devjamescollier/ESP-32_Based_Avionics_and_Telemetry_Board/Manufacturing/Assembly/BOM.csv

Comment | Designator | Footprint | LCSC Part #
100n | C1,C2,C3,C4,C5,C6,C8,C11,C13,C19,C21,C23,C25,C28 | C_0603_1608Metric | C14663
1u | C7,C15 | C_0603_1608Metric | C15849
10u | C12,C16,C20,C22,C27 | C_0805_2012Metric | C15850
4.7u | C14 | C_0805_2012Metric | C1779
22u | C17,C24 | C_0805_2012Metric | C45783
100u | C18,C26 | CP_Elec_6.3x5.4 | C7469933
YelGrn | D1 | LED_0603_1608Metric | C965805
Yellow | D2 | LED_0603_1608Metric | C89811
Red | D3 | LED_0603_1608Metric | C2286
SS54 | D4,D5 | D_SMA | C22452
B5819WS | D6 | D_SOD-323 | C64886
15A | F1 | Fuse_Littelfuse-NANO2-451_453 | C44480
Micro_SD_Card | J1 | microSD_HC_Hirose_DM3AT-SF-PEJM5 | C114218
USB_B_Micro | J6 | USB_Micro-B_Molex-105017-0001_EdgeSilk | C136000
4.7u | L1 | L_Changjiang_FNR4030S | C167874
MMBT3904 | Q1,Q2,Q3 | SOT-23 | C20526
AO4407A | Q4,Q5 | SOIC-8_3.9x4.9mm_P1.27mm | C16072
10k | R1,R2,R4,R5,R14,R15,R16,R17,R21,R22,R23,R27,R38,R39 | R_0603_1608Metric | C25804
100k | R3,R24,R28,R34,R35,R36,R37 | R_0603_1608Metric | C25803
4.7k | R8,R9 | R_0603_1608Metric | C23162
1k | R11,R12,R13,R18,R26,R29,R30,R31,R32,R33 | R_0603_1608Metric | C21190
22.1k | R19 | R_0603_1608Metric | C137768
47.5k | R20 | R_0603_1608Metric | C23061
39k | R25 | R_0603_1608Metric | C23153
SW_Push | SW1,SW2 | SW_Push_1P1T_XKB_TS-1187A | C318884
ESP32-WROOM-32E-N4 | U1 | ESP32-WROOM-32E_Espressif | C701341
ASM330LHHTR | U2 | LGA-14_3x2.5mm_P0.5mm_LayoutBorder3x4y | C459826
LSM6DSV32XTR | U3 | LGA-14_3x2.5mm_P0.5mm_LayoutBorder3x4y | C22461202
MS5611-01BA03 | U4 | TE_MS5611-01BA03_LGA-8_3x5mm_P1.25mm | C15639
LIS3MDLTR | U5 | LGA-12_2x2mm_P0.5mm | C478483
CP2102N-A02-GQFN28 | U6 | QFN-28-1EP_5x5mm_P0.5mm_EP3.35x3.35mm | C964632
AP63203WU-7 | U9 | TSOT-23-6 | C780769
USBLC6-2SC6 | U10 | SOT-23-6 | C7519
