devjamescollier/ESP-32_Based_Avionics_and_Telemetry_Board/Hardware/KiCad_Files/3D_Models/XT30PW-M.step

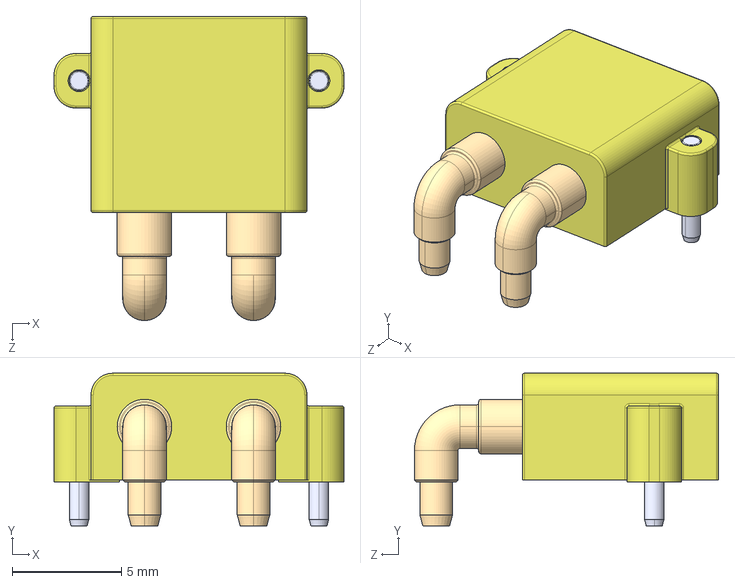
[picture p4: CAD file, 2025-08-06]
Hardware/KiCad_Files/3D_Models/XT30PW-M.step
13.3 x 7.00 x 14.0 mm
