devjamescollier/ESP-32_Based_Avionics_and_Telemetry_Board/Hardware/KiCad_Files/3D_Models/D_SOD-323.step

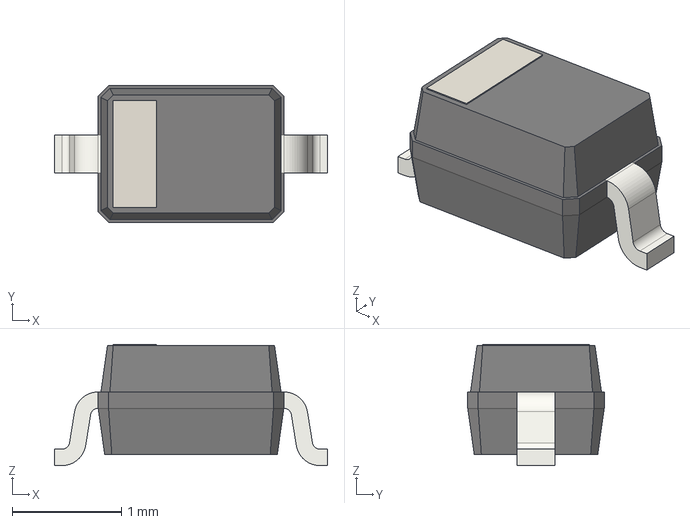
[picture p5: CAD file, 2025-08-06]
Hardware/KiCad_Files/3D_Models/D_SOD-323.step
2.50 x 1.25 x 1.11 mm
