devjamescollier/ESP-32_Based_Avionics_and_Telemetry_Board/Hardware/KiCad_Files/3D_Models/C_0805_2012Metric.step

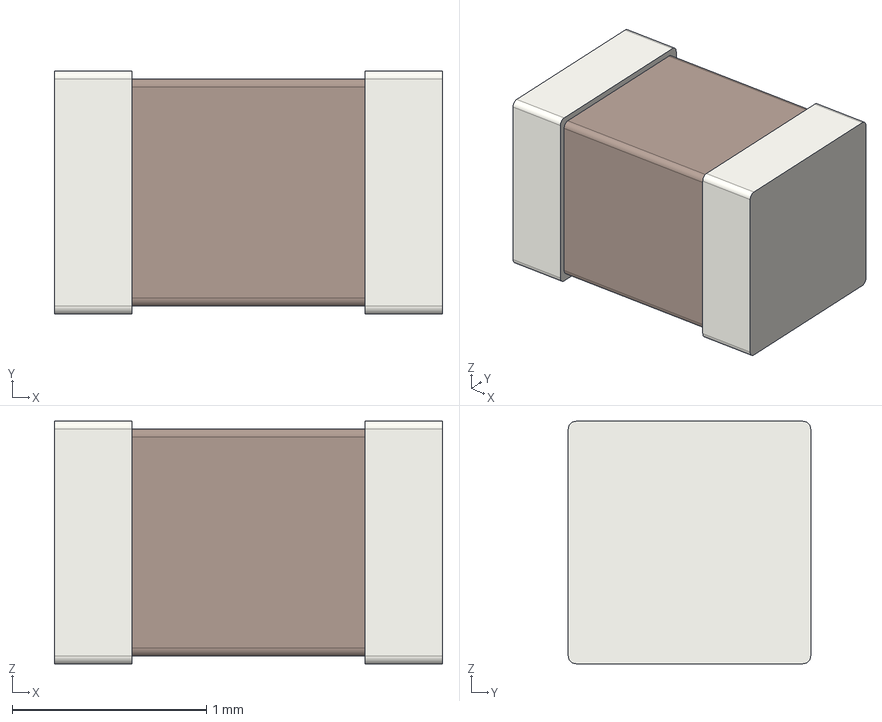
[picture p6: CAD file, 2025-08-06]
Hardware/KiCad_Files/3D_Models/C_0805_2012Metric.step
2.00 x 1.25 x 1.25 mm
