devjamescollier/ESP-32_Based_Avionics_and_Telemetry_Board/Hardware/KiCad_Files/3D_Models/SOT-23-6.step

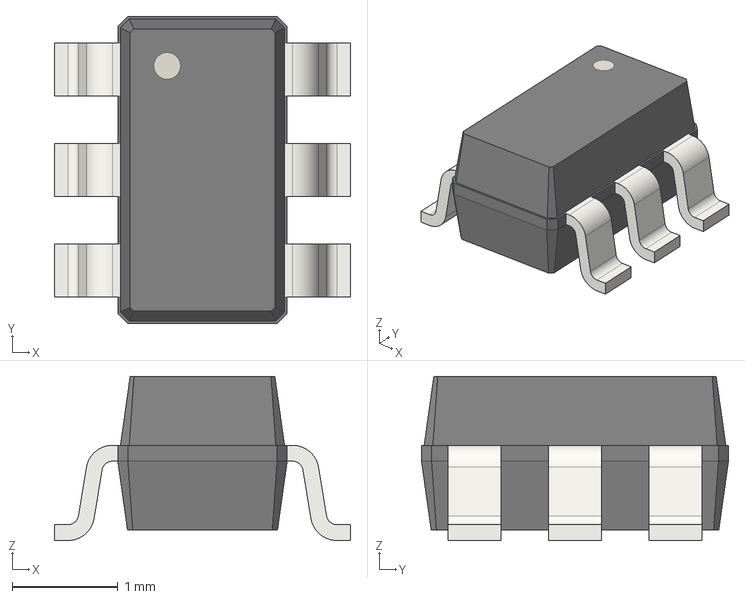
[picture p7: CAD file, 2025-08-06]
Hardware/KiCad_Files/3D_Models/SOT-23-6.step
2.80 x 2.90 x 1.55 mm
