devjamescollier/ESP-32_Based_Avionics_and_Telemetry_Board/Hardware/KiCad_Files/3D_Models/CP_Elec_6.3x5.4.step

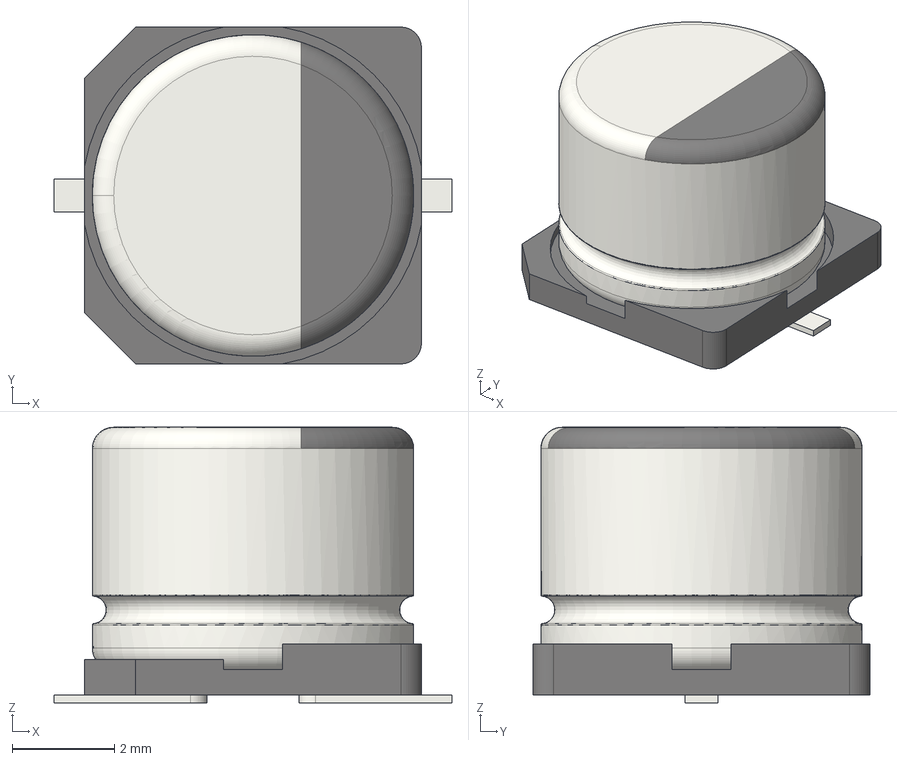
[picture p8: CAD file, 2025-08-06]
Hardware/KiCad_Files/3D_Models/CP_Elec_6.3x5.4.step
7.80 x 6.60 x 5.40 mm
