devjamescollier/ESP-32_Based_Avionics_and_Telemetry_Board/Hardware/KiCad_Files/3D_Models/L_Changjiang_FNR4030S.step

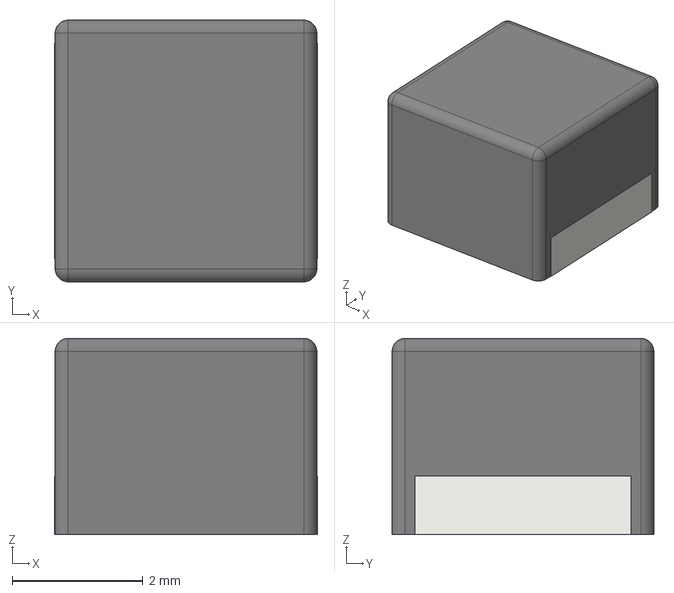
[picture p9: CAD file, 2025-08-06]
Hardware/KiCad_Files/3D_Models/L_Changjiang_FNR4030S.step
4.02 x 4.00 x 3.00 mm
