devjamescollier/ESP-32_Based_Avionics_and_Telemetry_Board/Hardware/KiCad_Files/3D_Models/C_0603_1608Metric.step

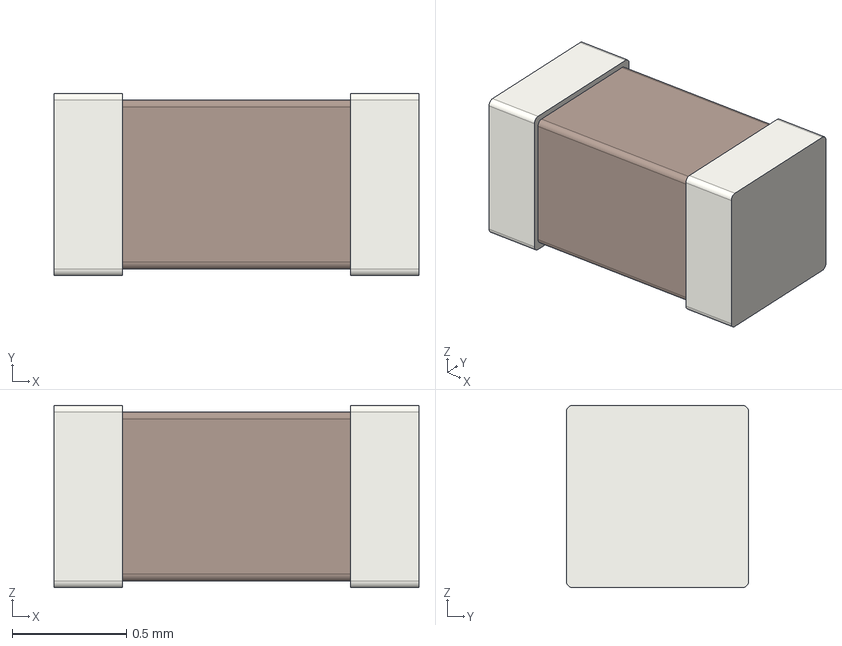
[picture p10: CAD file, 2025-08-06]
Hardware/KiCad_Files/3D_Models/C_0603_1608Metric.step
1.60 x 0.8 x 0.8 mm
