devjamescollier/ESP-32_Based_Avionics_and_Telemetry_Board/Hardware/KiCad_Files/3D_Models/PinHeader_1x03_P2.54mm_Vertical.step

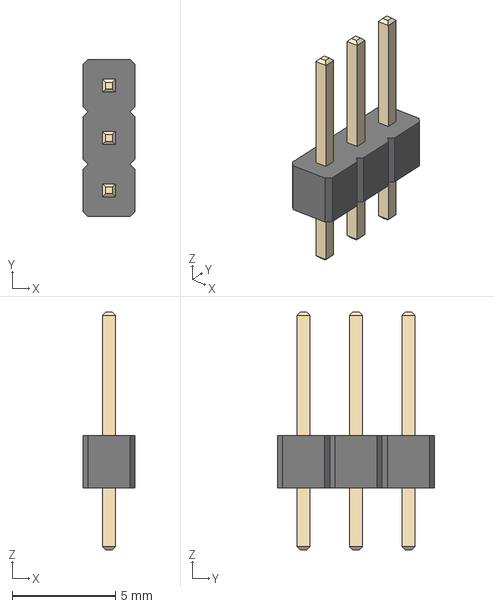
[picture p13: CAD file, 2025-08-06]
Hardware/KiCad_Files/3D_Models/PinHeader_1x03_P2.54mm_Vertical.step
2.54 x 7.62 x 11.5 mm
