devjamescollier/ESP-32_Based_Avionics_and_Telemetry_Board/Hardware/KiCad_Files/3D_Models/SS12D10G5.step

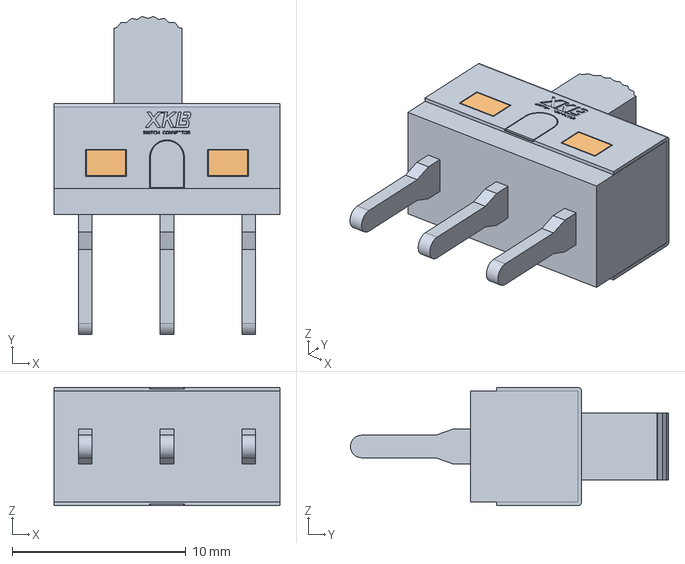
[picture p14: CAD file, 2025-08-06]
Hardware/KiCad_Files/3D_Models/SS12D10G5.step
13.0 x 18.3 x 6.80 mm
