devjamescollier/ESP-32_Based_Avionics_and_Telemetry_Board/Hardware/KiCad_Files/3D_Models/D_SMA.step

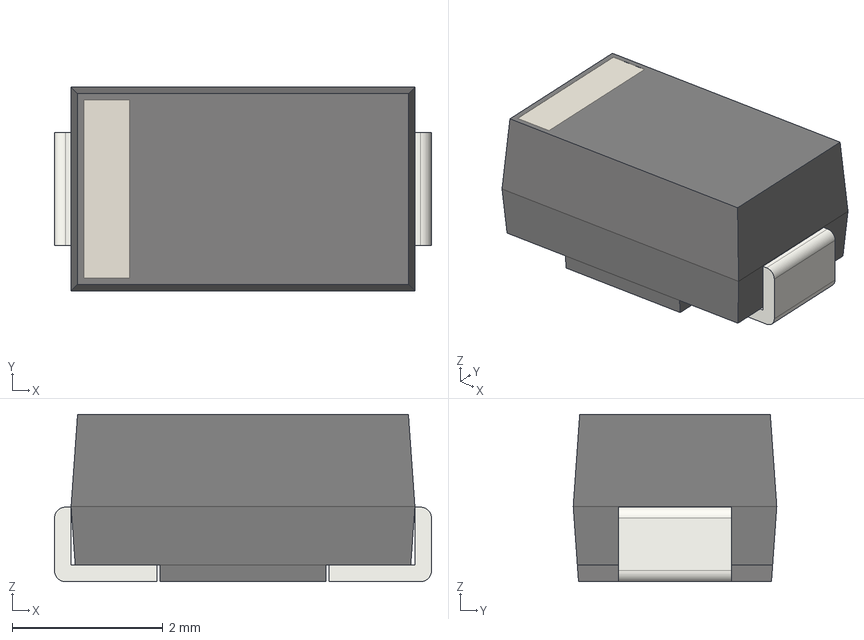
[picture p15: CAD file, 2025-08-06]
Hardware/KiCad_Files/3D_Models/D_SMA.step
5.00 x 2.70 x 2.22 mm
