devjamescollier/ESP-32_Based_Avionics_and_Telemetry_Board/Hardware/KiCad_Files/3D_Models/Littelfuse_0451.step

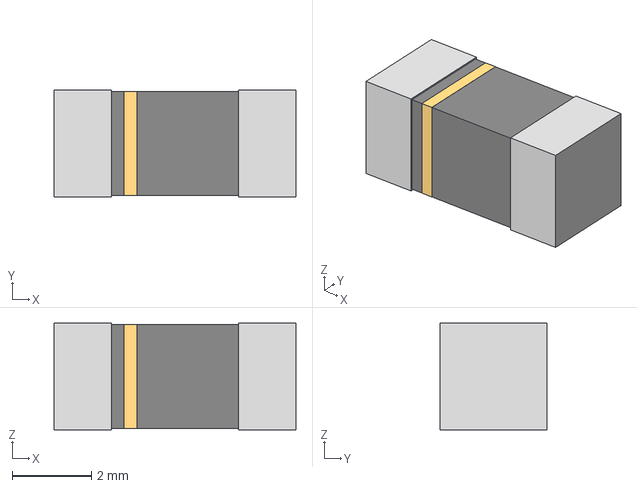
[picture p16: CAD file, 2025-08-06]
Hardware/KiCad_Files/3D_Models/Littelfuse_0451.step
6.10 x 2.69 x 2.69 mm
