devjamescollier/ESP-32_Based_Avionics_and_Telemetry_Board/Hardware/KiCad_Files/3D_Models/Buzzer_12x9.5RM7.6.step

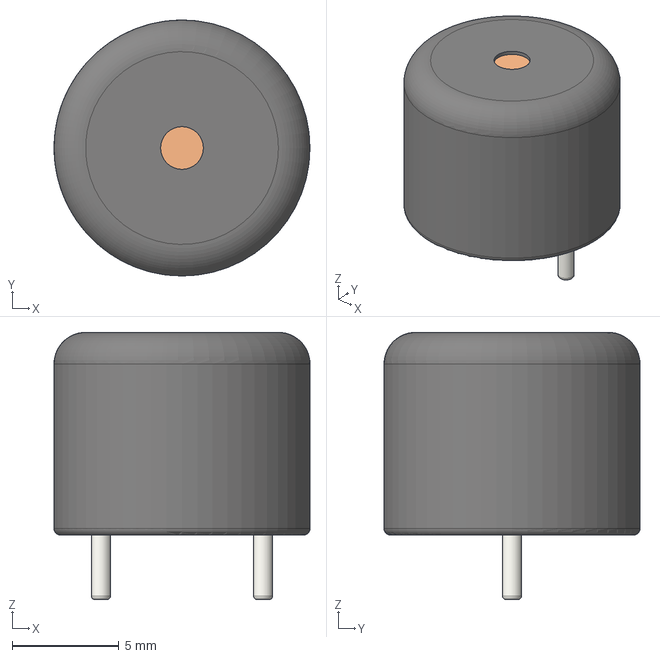
[picture p18: CAD file, 2025-08-06]
Hardware/KiCad_Files/3D_Models/Buzzer_12x9.5RM7.6.step
12.0 x 12.0 x 12.5 mm
