devjamescollier/ESP-32_Based_Avionics_and_Telemetry_Board/Hardware/KiCad_Files/3D_Models/SOT-23.step

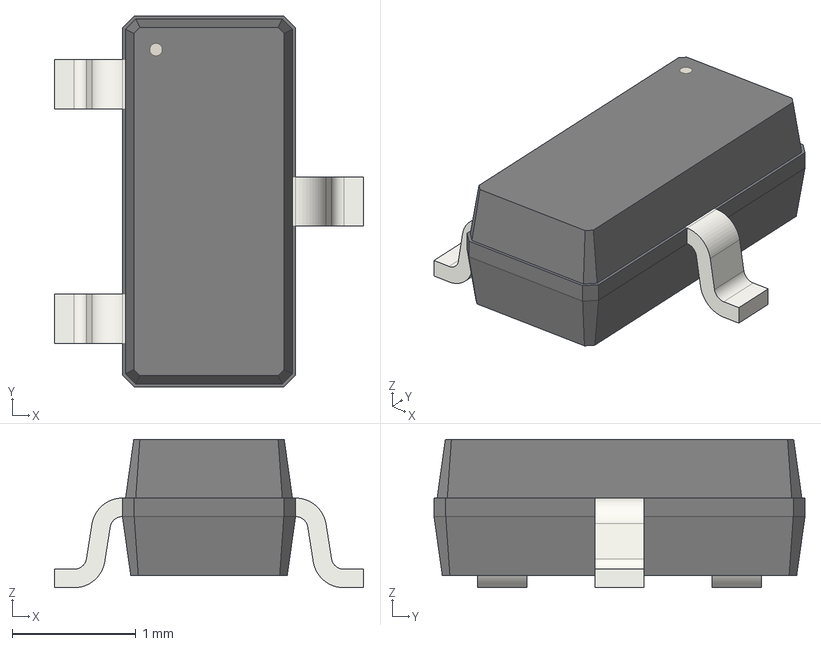
[picture p19: CAD file, 2025-08-06]
Hardware/KiCad_Files/3D_Models/SOT-23.step
2.50 x 3.00 x 1.20 mm
