devjamescollier/ESP-32_Based_Avionics_and_Telemetry_Board/Hardware/KiCad_Files/3D_Models/Molex_105017-0001.step

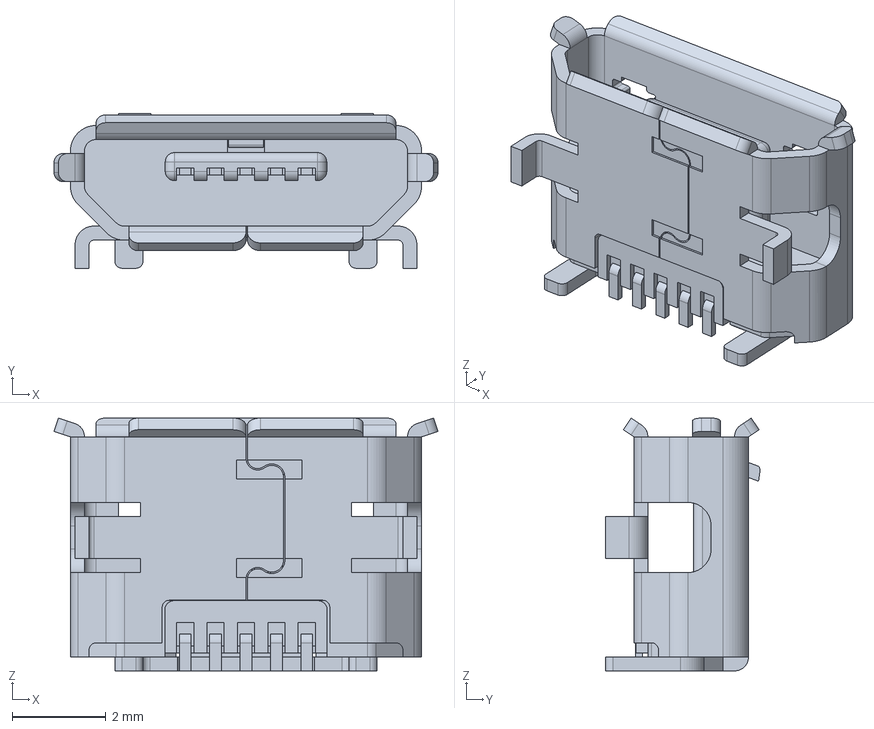
[picture p20: CAD file, 2025-08-06]
Hardware/KiCad_Files/3D_Models/Molex_105017-0001.step
8.20 x 3.30 x 5.40 mm
