devjamescollier/ESP-32_Based_Avionics_and_Telemetry_Board/Hardware/KiCad_Files/3D_Models/TS-1187A-B-A-B.step

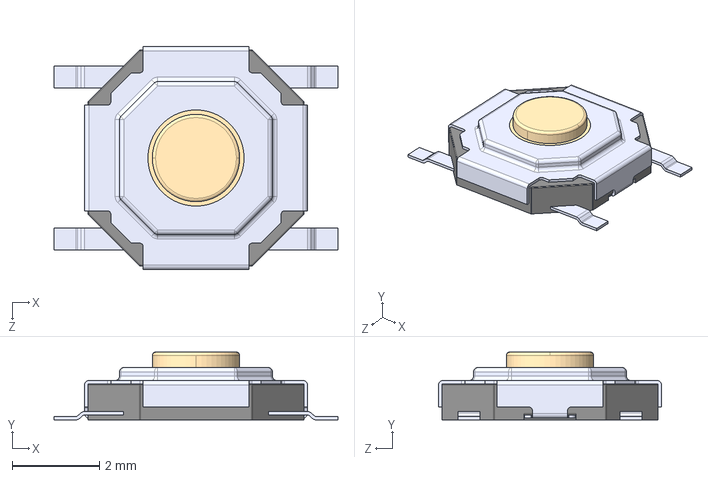
[picture p21: CAD file, 2025-08-06]
Hardware/KiCad_Files/3D_Models/TS-1187A-B-A-B.step
6.50 x 1.55 x 5.10 mm
