devjamescollier/ESP-32_Based_Avionics_and_Telemetry_Board/Hardware/KiCad_Files/3D_Models/LGA-12_2x2mm_P0.5mm.step

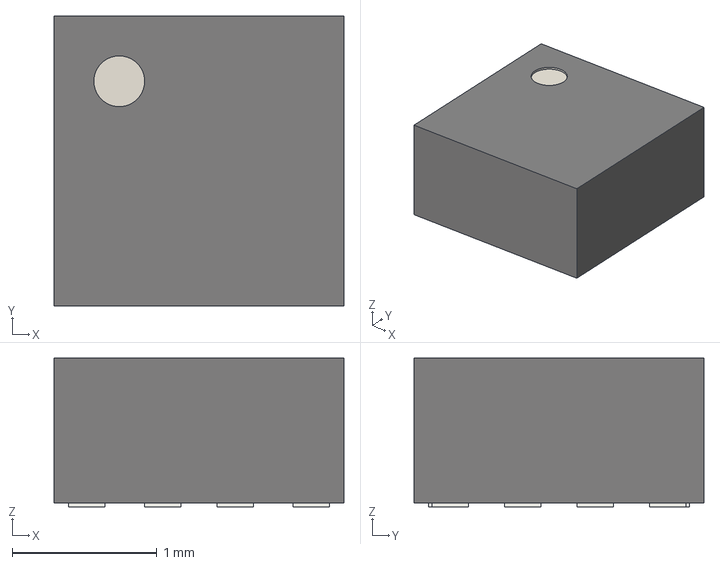
[picture p22: CAD file, 2025-08-05]
Hardware/KiCad_Files/3D_Models/LGA-12_2x2mm_P0.5mm.step
2.00 x 2.00 x 1.02 mm
