devjamescollier/ESP-32_Based_Avionics_and_Telemetry_Board/Hardware/KiCad_Files/3D_Models/LGA-14_3x2.5mm_P0.5mm_LayoutBorder3x4y.step

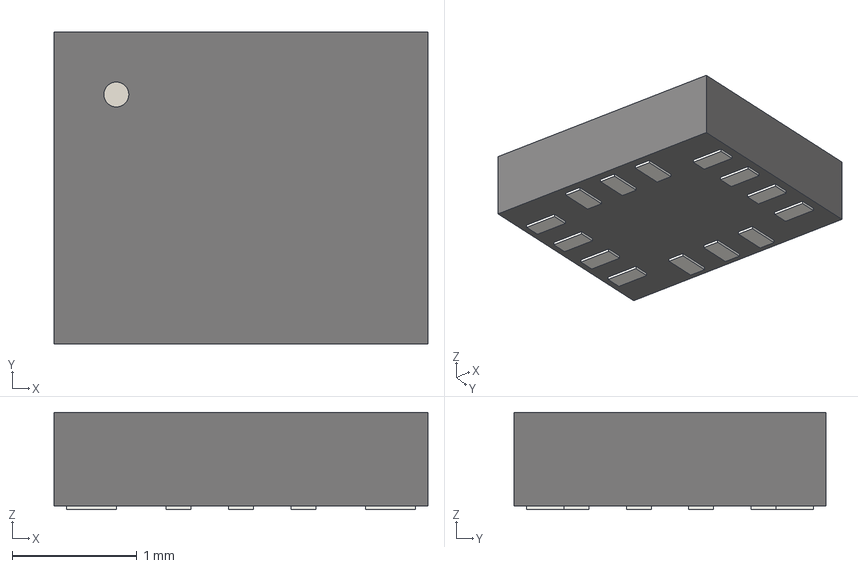
[picture p23: CAD file, 2025-08-05]
Hardware/KiCad_Files/3D_Models/LGA-14_3x2.5mm_P0.5mm_LayoutBorder3x4y.step
3.00 x 2.50 x 0.78 mm
