devjamescollier/ESP-32_Based_Avionics_and_Telemetry_Board/Hardware/KiCad_Files/3D_Models/microSD_HC_Hirose_DM3AT-SF-PEJM5.step

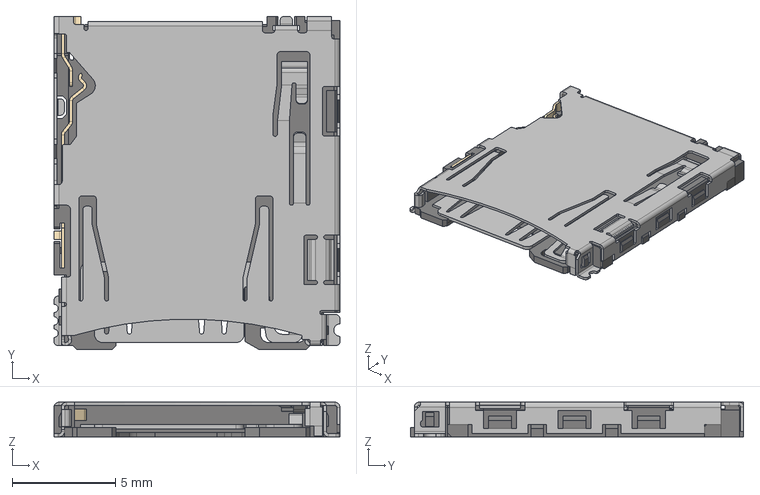
[picture p24: CAD file, 2025-08-05]
Hardware/KiCad_Files/3D_Models/microSD_HC_Hirose_DM3AT-SF-PEJM5.step
13.8 x 16.1 x 1.68 mm
