devjamescollier/ESP-32_Based_Avionics_and_Telemetry_Board/Hardware/KiCad_Files/3D_Models/SOIC-8_3.9x4.9mm_P1.27mm.step

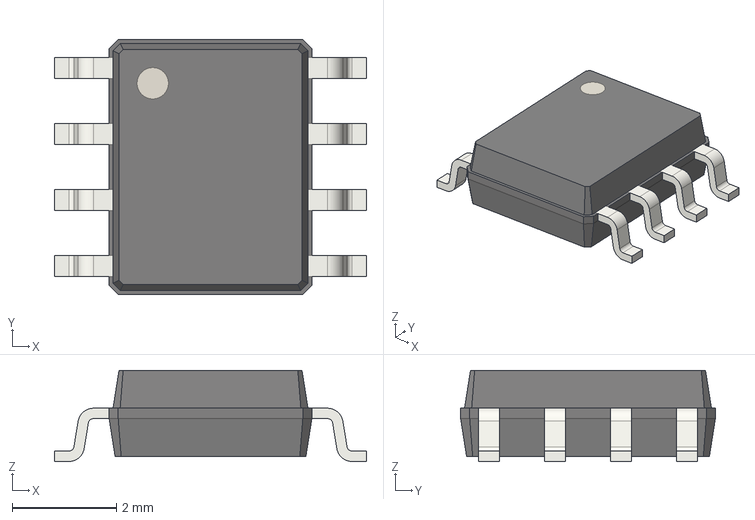
[picture p25: CAD file, 2025-08-05]
Hardware/KiCad_Files/3D_Models/SOIC-8_3.9x4.9mm_P1.27mm.step
6.00 x 4.90 x 1.75 mm
