devjamescollier/ESP-32_Based_Avionics_and_Telemetry_Board/Hardware/KiCad_Files/3D_Models/QFN-28-1EP_5x5mm_P0.5mm_EP3.35x3.35mm.step

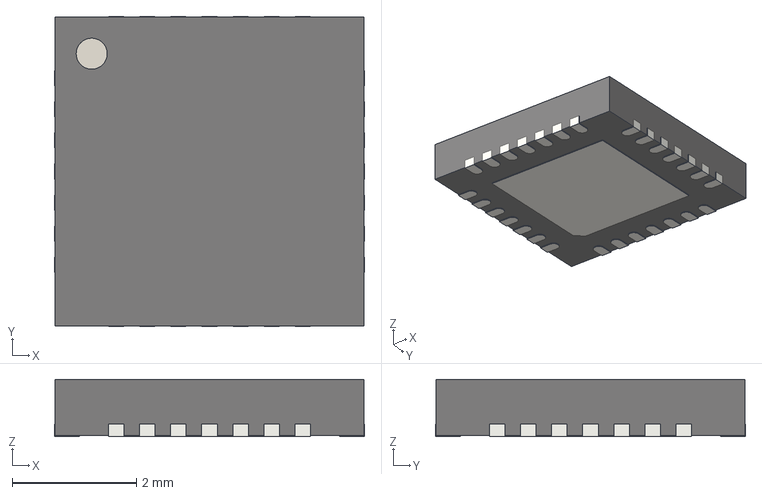
[picture p26: CAD file, 2025-08-05]
Hardware/KiCad_Files/3D_Models/QFN-28-1EP_5x5mm_P0.5mm_EP3.35x3.35mm.step
5.00 x 5.00 x 0.92 mm
