devjamescollier/ESP-32_Based_Avionics_and_Telemetry_Board/Hardware/KiCad_Files/3D_Models/ESP32-WROOM-32E.step

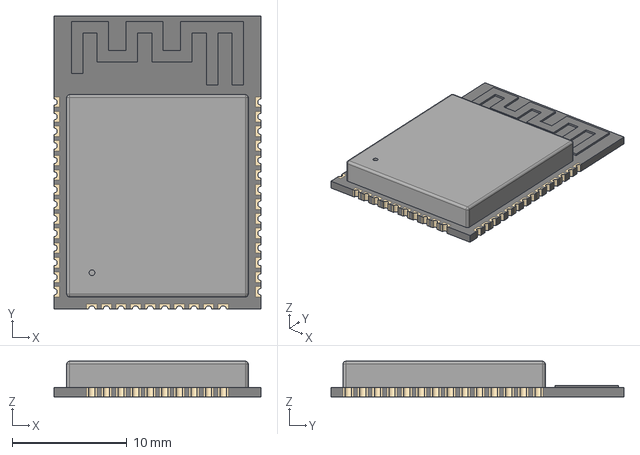
[picture p27: CAD file, 2025-08-05]
Hardware/KiCad_Files/3D_Models/ESP32-WROOM-32E.step
18.0 x 25.5 x 3.10 mm
