devjamescollier/ESP-32_Based_Avionics_and_Telemetry_Board/Hardware/KiCad_Files/ESP-32_Based_Avionics_Telemetry_Board.kicad_pcb

## KiCad design Hardware/KiCad_Files/ESP-32_Based_Avionics_Telemetry_Board.kicad_pcb (2025-08-11)

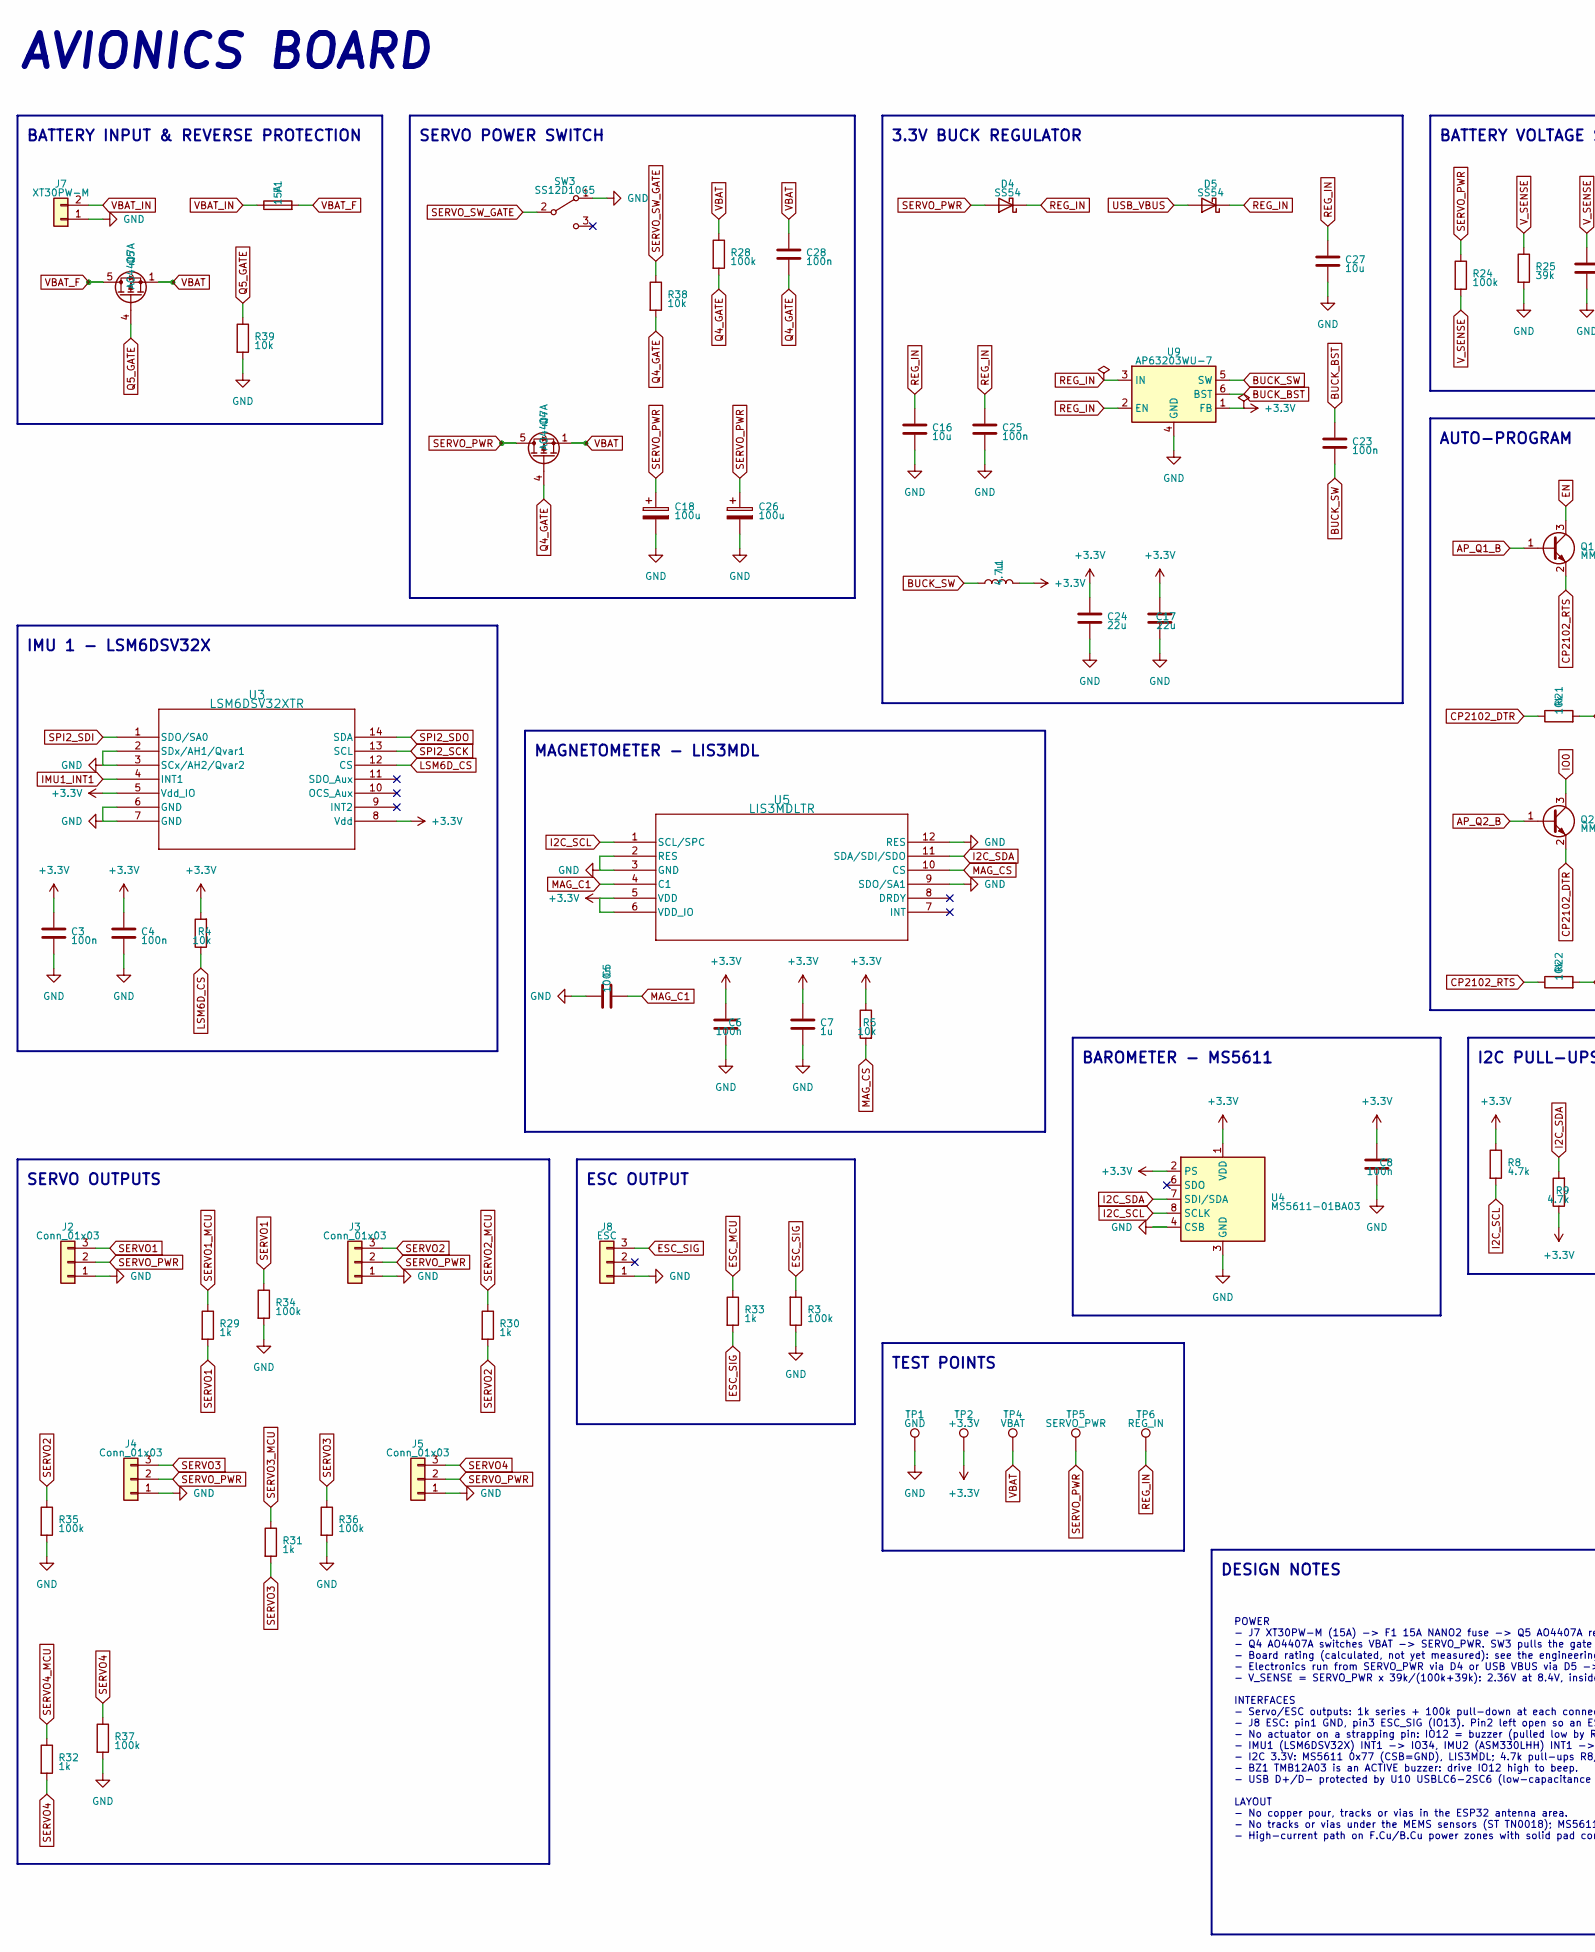
[picture p29: schematic ESP-32_Based_Avionics_Telemetry_Board.kicad_sch, ESP32-Based Avionics Board, part in row 1, column 1]

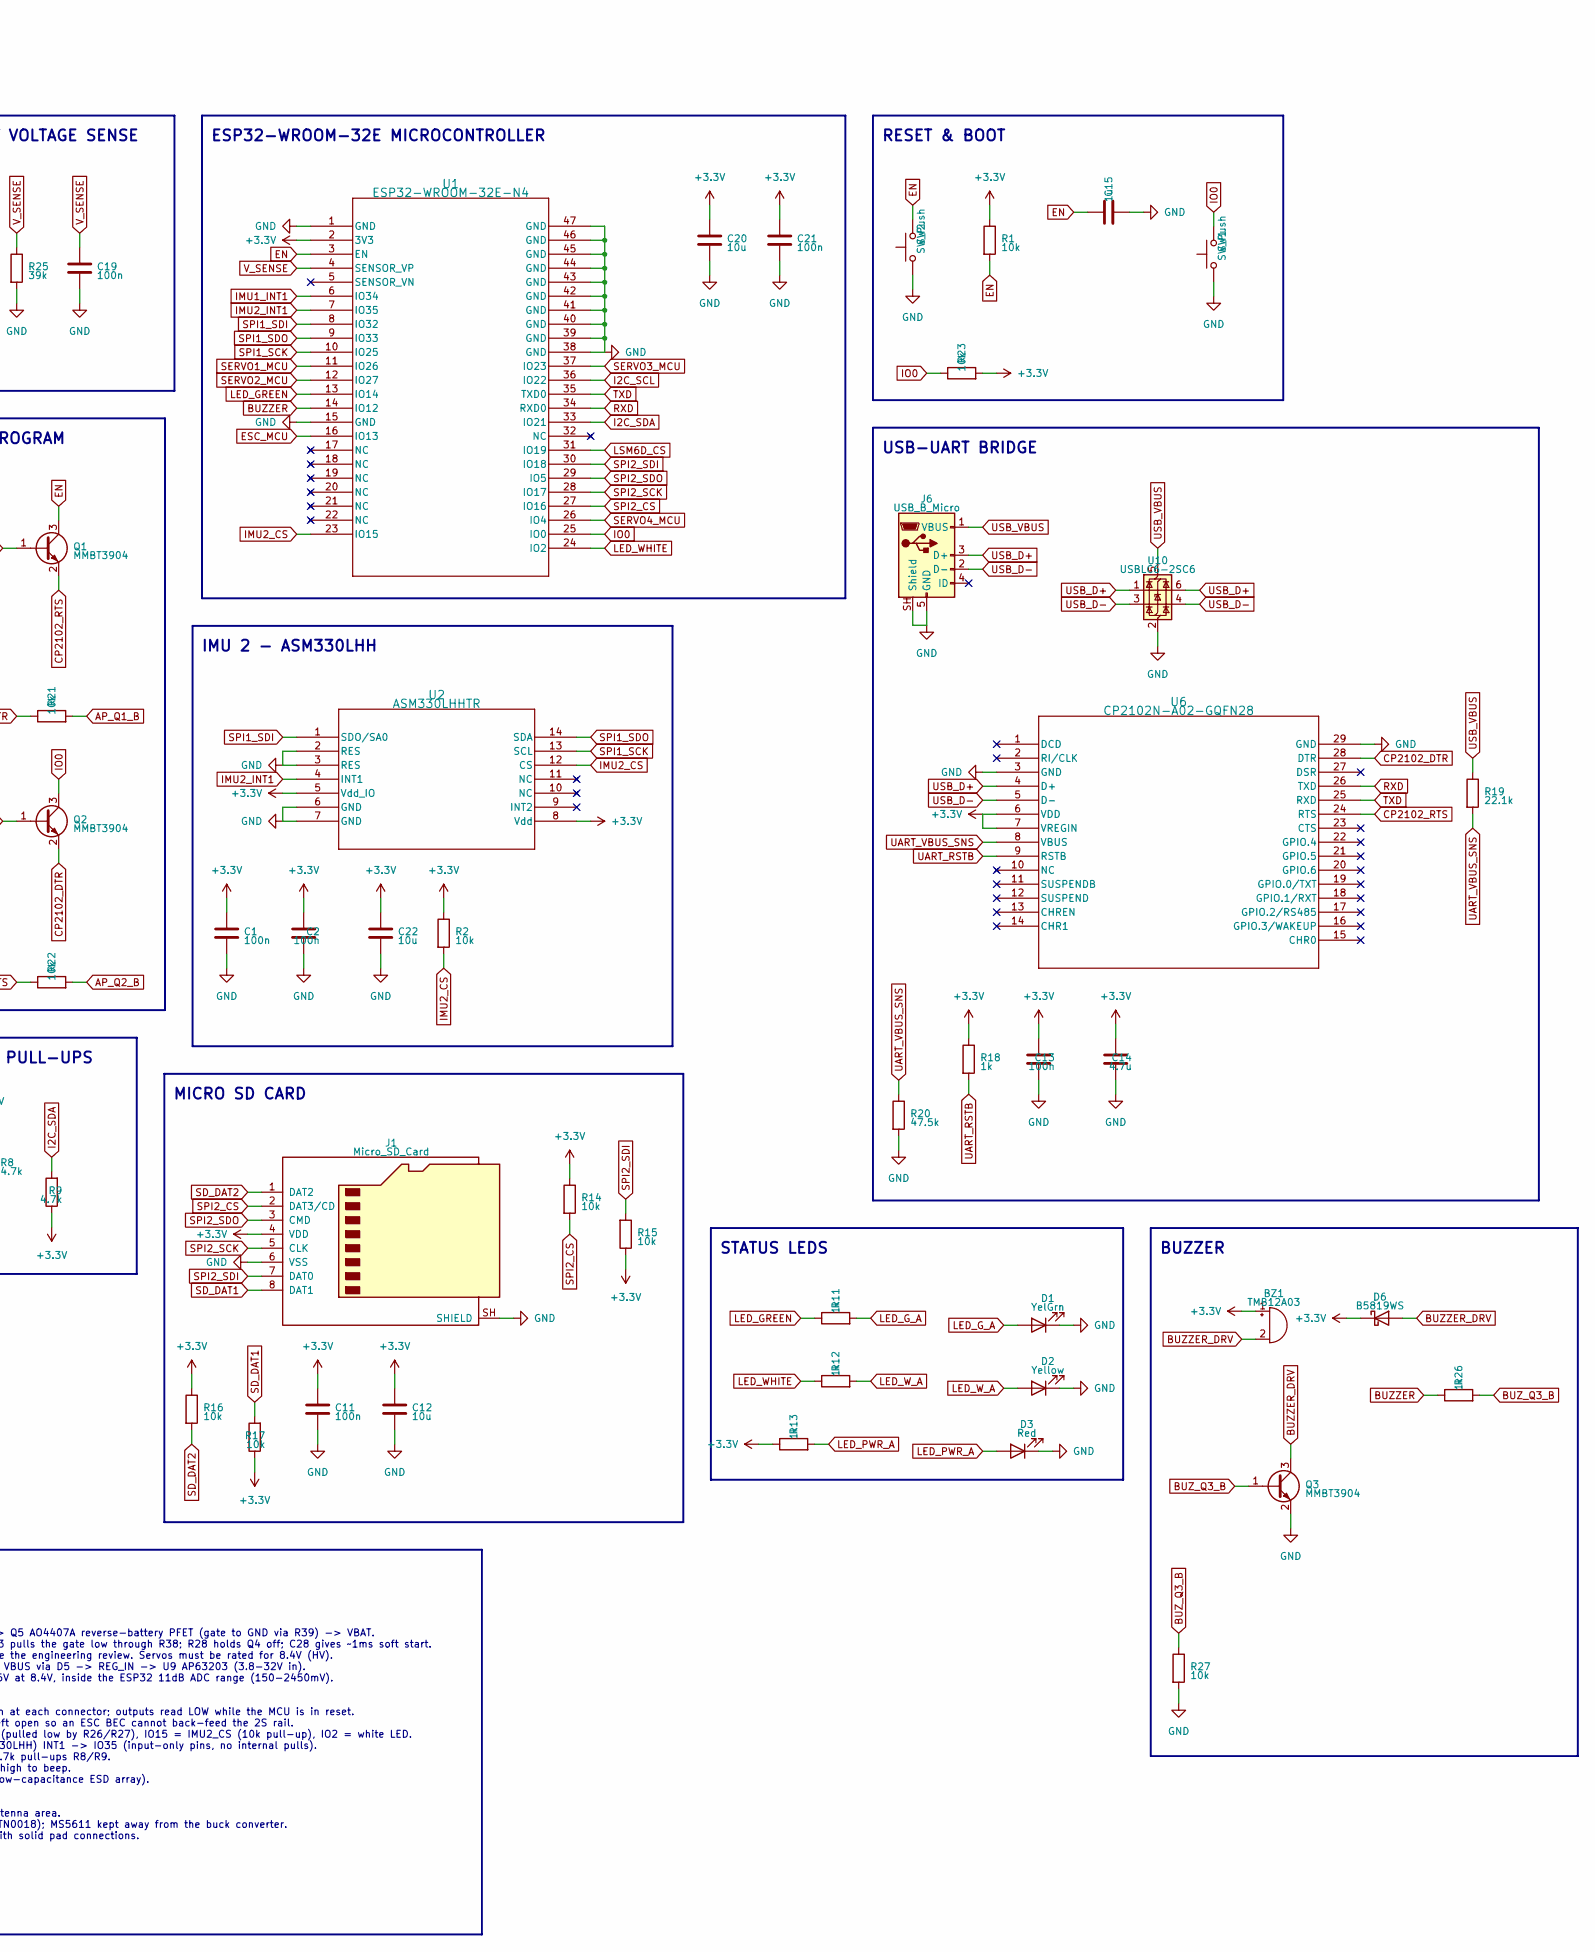
[picture p30: schematic ESP-32_Based_Avionics_Telemetry_Board.kicad_sch, ESP32-Based Avionics Board, part in row 1, column 2]

Parts:
BZ1: TMB12A03; Buzzer_12x9.5RM7.6; LCSC C96222
C1, C2, C3, C4, C5, C6, C8, C11, C13, C19, C21, C23, C25, C28: 100n; C_0603_1608Metric; LCSC C14663
C7, C15: 1u; C_0603_1608Metric; LCSC C15849
C12, C16, C20, C22, C27: 10u; C_0805_2012Metric; LCSC C15850
C14: 4.7u; C_0805_2012Metric; LCSC C1779
C17, C24: 22u; C_0805_2012Metric; LCSC C45783
C18, C26: 100u; CP_Elec_6.3x5.4; LCSC C7469933
D1: YelGrn; LED_0603_1608Metric; LCSC C965805
D2: Yellow; LED_0603_1608Metric; LCSC C89811
D3: Red; LED_0603_1608Metric; LCSC C2286
D4, D5: SS54; D_SMA; LCSC C22452
D6: B5819WS; D_SOD-323; LCSC C64886
F1: 15A; Fuse_Littelfuse-NANO2-451_453; LCSC C44480
J1: Micro_SD_Card; microSD_HC_Hirose_DM3AT-SF-PEJM5; LCSC C114218
J2, J3, J4, J5: Conn_01x03; PinHeader_1x03_P2.54mm_Vertical; LCSC C49257
J6: USB_B_Micro; USB_Micro-B_Molex-105017-0001_EdgeSilk; LCSC C136000
J7: XT30PW-M; AMASS_XT30PW-M_1x02_P2.50mm_Horizontal; LCSC C431092
J8: ESC; PinHeader_1x03_P2.54mm_Vertical; LCSC C49257
L1: 4.7u; L_Changjiang_FNR4030S; MPN FNR4030S4R7MT; LCSC C167874
Q1, Q2, Q3: MMBT3904; SOT-23; LCSC C20526
Q4, Q5: AO4407A; SOIC-8_3.9x4.9mm_P1.27mm; LCSC C16072
R1, R2, R4, R5, R14, R15, R16, R17, R21, R22, R23, R27, R38, R39: 10k; R_0603_1608Metric; LCSC C25804
R3, R24, R28, R34, R35, R36, R37: 100k; R_0603_1608Metric; LCSC C25803
R8, R9: 4.7k; R_0603_1608Metric; LCSC C23162
R11, R12, R13, R18, R26, R29, R30, R31, R32, R33: 1k; R_0603_1608Metric; LCSC C21190
R19: 22.1k; R_0603_1608Metric; LCSC C137768
R20: 47.5k; R_0603_1608Metric; LCSC C23061
R25: 39k; R_0603_1608Metric; LCSC C23153
SW1, SW2: SW_Push; SW_Push_1P1T_XKB_TS-1187A; LCSC C318884
SW3: SS12D10G5; SW_Slide_SPDT_Vertical_ShouHan_SS12D10_P4.8mm; LCSC C7431054
TP1: GND; TestPoint_Pad_D1.5mm
TP2: +3.3V; TestPoint_Pad_D1.5mm
TP4: VBAT; TestPoint_Pad_D1.5mm
TP5: SERVO_PWR; TestPoint_Pad_D1.5mm
TP6: REG_IN; TestPoint_Pad_D1.5mm
U1: ESP32-WROOM-32E-N4; ESP32-WROOM-32E_Espressif; LCSC C701341
U2: ASM330LHHTR; LGA-14_3x2.5mm_P0.5mm_LayoutBorder3x4y; LCSC C459826
U3: LSM6DSV32XTR; LGA-14_3x2.5mm_P0.5mm_LayoutBorder3x4y; LCSC C22461202
U4: MS5611-01BA03; TE_MS5611-01BA03_LGA-8_3x5mm_P1.25mm; LCSC C15639
U5: LIS3MDLTR; LGA-12_2x2mm_P0.5mm; LCSC C478483
U6: CP2102N-A02-GQFN28; QFN-28-1EP_5x5mm_P0.5mm_EP3.35x3.35mm; LCSC C964632
U9: AP63203WU-7; TSOT-23-6; LCSC C780769
U10: USBLC6-2SC6; SOT-23-6; LCSC C7519

Connections:
+3.3V: BZ1.1 (+), C1.2, C2.2, C3.2, C4.2, C6.1, C7.1, C8.2, C11.1, C12.1, C13.2, C14.2, C17.1, C20.1, C21.1, C22.1, C24.1, D6.1 (K), J1.4 (VDD), L1.2, R1.1, R2.1, R4.2, R5.1, R8.1, R9.1, R13.1, R14.1, R15.1, R16.1, R17.1, R18.1, R23.2, TP2.1, U1.2 (3V3), U2.5 (Vdd_IO), U2.8 (Vdd), U3.5 (Vdd_IO), U3.8 (Vdd), U4.1 (VDD), U4.2 (PS), U5.5 (VDD), U5.6 (VDD_IO), U6.6 (VDD), U6.7 (VREGIN), U9.1 (FB)
AP_Q1_B: Q1.1 (B), R21.2
AP_Q2_B: Q2.1 (B), R22.2
BUCK_BST: C23.1, U9.6 (BST)
BUCK_SW: C23.2, L1.1, U9.5 (SW)
BUZZER: R26.1, U1.14 (IO12)
BUZZER_DRV: BZ1.2 (-), D6.2 (A), Q3.3 (C)
BUZ_Q3_B: Q3.1 (B), R26.2, R27.1
CP2102_DTR: Q2.2 (E), R21.1, U6.28 (DTR)
CP2102_RTS: Q1.2 (E), R22.1, U6.24 (RTS)
EN: C15.1, Q1.3 (C), R1.2, SW2.2, U1.3 (EN)
ESC_MCU: R33.1, U1.16 (IO13)
ESC_SIG: J8.3, R3.2, R33.2
GND: C1.1, C2.1, C3.1, C4.1, C5.2, C6.2, C7.2, C8.1, C11.2, C12.2, C13.1, C14.1, C15.2, C16.2, C17.2, C18.2, C19.2, C20.2, C21.2, C22.2, C24.2, C25.2, C26.2, C27.2, D1.1 (K), D2.1 (K), D3.1 (K), J1.6 (VSS), J1.SH (SHIELD), J2.1, J3.1, J4.1, J5.1, J6.5 (GND), J6.SH (Shield), J7.1, J8.1, Q3.2 (E), R3.1, R20.2, R25.2, R27.2, R34.2, R35.2, R36.2, R37.2, R39.2, SW1.1, SW2.1, SW3.1 (A), TP1.1, U1.1 (GND), U1.15 (GND), U1.38 (GND), U1.39 (GND), U1.40 (GND), U1.41 (GND), U1.42 (GND), U1.43 (GND), U1.44 (GND), U1.45 (GND), U1.46 (GND), U1.47 (GND), U2.2 (RES), U2.3 (RES), U2.6 (GND), U2.7 (GND), U3.2 (SDx/AH1/Qvar1), U3.3 (SCx/AH2/Qvar2), U3.6 (GND), U3.7 (GND), U4.3 (GND), U4.4 (CSB), U4.5 (CSB), U5.2 (RES), U5.3 (GND), U5.9 (SDO/SA1), U5.12 (RES), U6.3 (GND), U6.29 (GND), U9.4 (GND), U10.2 (GND)
I2C_SCL: R8.2, U1.36 (IO22), U4.8 (SCLK), U5.1 (SCL/SPC)
I2C_SDA: R9.2, U1.33 (IO21), U4.7 (SDI/SDA), U5.11 (SDA/SDI/SDO)
IMU1_INT1: U1.6 (IO34), U3.4 (INT1)
IMU2_CS: R2.2, U1.23 (IO15), U2.12 (CS)
IMU2_INT1: U1.7 (IO35), U2.4 (INT1)
IO0: Q2.3 (C), R23.1, SW1.2, U1.25 (IO0)
LED_GREEN: R11.1, U1.13 (IO14)
LED_G_A: D1.2 (A), R11.2
LED_PWR_A: D3.2 (A), R13.2
LED_WHITE: R12.1, U1.24 (IO2)
LED_W_A: D2.2 (A), R12.2
LSM6D_CS: R4.1, U1.31 (IO19), U3.12 (CS)
MAG_C1: C5.1, U5.4 (C1)
MAG_CS: R5.2, U5.10 (CS)
Q4_GATE: C28.2, Q4.4 (G), R28.2, R38.2
Q5_GATE: Q5.4 (G), R39.1
REG_IN: C16.1, C25.1, C27.1, D4.1 (K), D5.1 (K), TP6.1, U9.2 (EN), U9.3 (IN)
RXD: U1.34 (RXD0), U6.26 (TXD)
SD_DAT1: J1.8 (DAT1), R17.2
SD_DAT2: J1.1 (DAT2), R16.2
SERVO1: J2.3, R29.2, R34.1
SERVO1_MCU: R29.1, U1.11 (IO26)
SERVO2: J3.3, R30.2, R35.1
SERVO2_MCU: R30.1, U1.12 (IO27)
SERVO3: J4.3, R31.2, R36.1
SERVO3_MCU: R31.1, U1.37 (IO23)
SERVO4: J5.3, R32.2, R37.1
SERVO4_MCU: R32.1, U1.26 (IO4)
SERVO_PWR: C18.1, C26.1, D4.2 (A), J2.2, J3.2, J4.2, J5.2, Q4.5 (D), Q4.6 (D), Q4.7 (D), Q4.8 (D), R24.1, TP5.1
SERVO_SW_GATE: R38.1, SW3.2 (B)
SPI1_SCK: U1.10 (IO25), U2.13 (SCL)
SPI1_SDI: U1.8 (IO32), U2.1 (SDO/SA0)
SPI1_SDO: U1.9 (IO33), U2.14 (SDA)
SPI2_CS: J1.2 (DAT3/CD), R14.2, U1.27 (IO16)
SPI2_SCK: J1.5 (CLK), U1.28 (IO17), U3.13 (SCL)
SPI2_SDI: J1.7 (DAT0), R15.2, U1.30 (IO18), U3.1 (SDO/SA0)
SPI2_SDO: J1.3 (CMD), U1.29 (IO5), U3.14 (SDA)
TXD: U1.35 (TXD0), U6.25 (RXD)
UART_RSTB: R18.2, U6.9 (RSTB)
UART_VBUS_SNS: R19.2, R20.1, U6.8 (VBUS)
USB_D+: J6.3 (D+), U6.4 (D+), U10.1 (I/O1), U10.6 (I/O1)
USB_D-: J6.2 (D-), U6.5 (D-), U10.3 (I/O2), U10.4 (I/O2)
USB_VBUS: D5.2 (A), J6.1 (VBUS), R19.1, U10.5 (VBUS)
VBAT: C28.1, Q4.1 (S), Q4.2 (S), Q4.3 (S), Q5.1 (S), Q5.2 (S), Q5.3 (S), R28.1, TP4.1
VBAT_F: F1.2, Q5.5 (D), Q5.6 (D), Q5.7 (D), Q5.8 (D)
VBAT_IN: F1.1, J7.2
V_SENSE: C19.1, R24.2, R25.1, U1.4 (SENSOR_VP)

Notes on the sheet:
BATTERY INPUT & REVERSE PROTECTION
SERVO POWER SWITCH
3.3V BUCK REGULATOR
BATTERY VOLTAGE SENSE
ESP32-WROOM-32E MICROCONTROLLER
RESET & BOOT
USB-UART BRIDGE
AUTO-PROGRAM
IMU 1 - LSM6DSV32X
IMU 2 - ASM330LHH
MAGNETOMETER - LIS3MDL
BAROMETER - MS5611
I2C PULL-UPS
MICRO SD CARD
SERVO OUTPUTS
ESC OUTPUT
STATUS LEDS
BUZZER
TEST POINTS
DESIGN NOTES
POWER - J7 XT30PW-M (15A) -> F1 15A NANO2 fuse -> Q5 AO4407A reverse-battery PFET (gate to GND via R39) -> VBAT. - Q4 AO4407A switches VBAT -> SERVO_PWR. SW3 pulls the gate low through R38; R28 holds Q4 off; C28 gives ~1ms soft start. - Board rating (calculated, not yet measured): see the engineeri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
AVIONICS BOARD

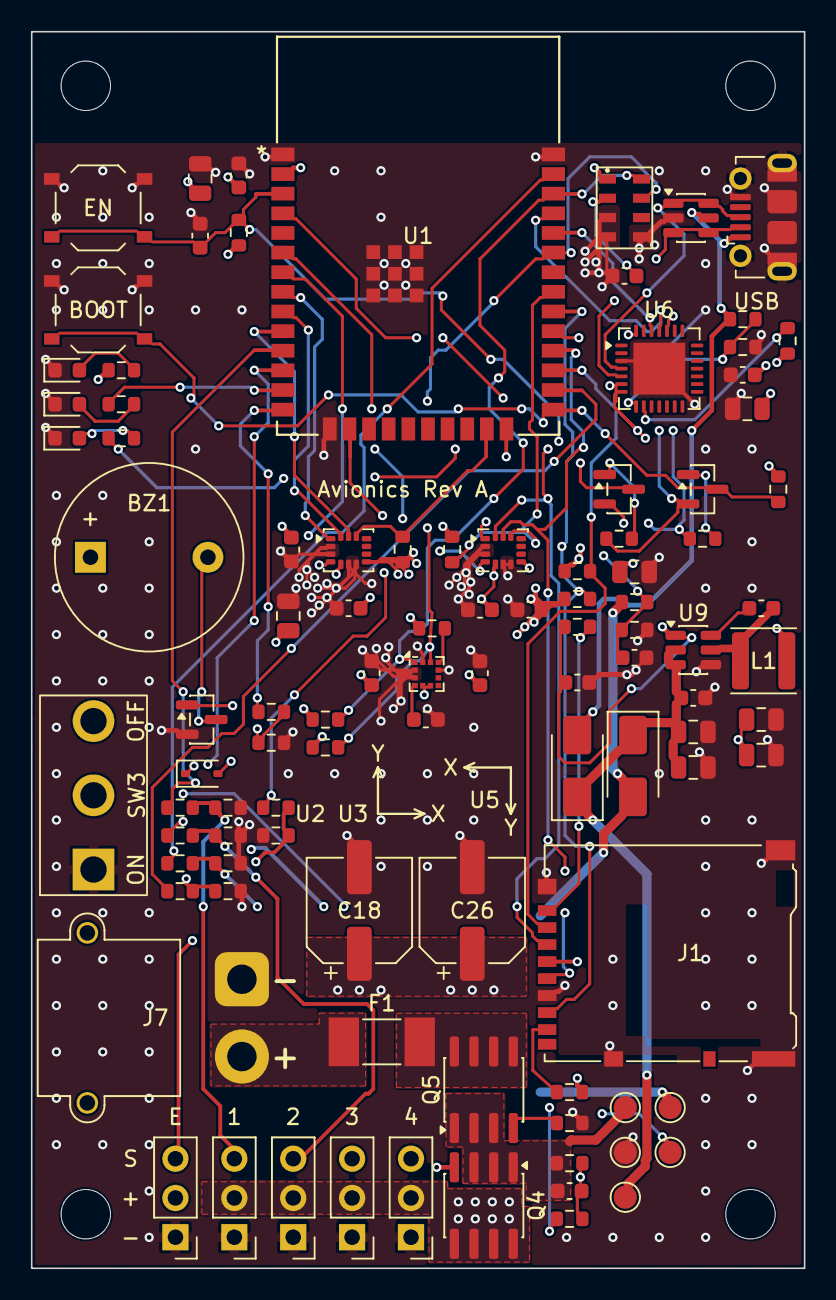
[picture p31: board ESP-32_Based_Avionics_Telemetry_Board.kicad_pcb from above]

Board: 4 copper layers, 50.0 x 80.0 mm, 104 parts (0 on the bottom side), 61 nets.

Other parts of the board:
H1, H2, H3, H4: M3; MountingHole_3.2mm_M3
