devjamescollier/ESP-32_Based_Avionics_and_Telemetry_Board/(commit log)

2025-08-04 Add ESP32 and peripheral footprints
2025-08-05 Add ESP32 and sensor 3D models
    [ESP32-WROOM-32E.step, LGA-12_2x2mm_P0.5mm.step, LGA-14_3x2.5mm_P0.5mm_LayoutBorder3x4y.step, QFN-28-1EP_5x5mm_P0.5mm_EP3.35x3.35mm.step, SOIC-8_3.9x4.9mm_P1.27mm.step, microSD_HC_Hirose_DM3AT-SF-PEJM5.step]
2025-08-06 Add power and passive component 3D models
    [Buzzer_12x9.5RM7.6.step, CP_Elec_6.3x5.4.step, C_0603_1608Metric.step, C_0805_2012Metric.step, D_SMA.step, D_SOD-323.step, LED_0603_1608Metric.step, L_Changjiang_FNR4030S.step]
2025-08-08 Add avionics schematic
    [ESP-32_Based_Avionics_Telemetry_Board.kicad_sch]
2025-08-11 Add four-layer PCB layout and project file
    [ESP-32_Based_Avionics_Telemetry_Board.kicad_pcb]
2025-08-17 Add four-layer Gerber and drill files
    [ESP-32_Based_Avionics_Telemetry_Board-B_Cu.gbl, ESP-32_Based_Avionics_Telemetry_Board-B_Mask.gbs, ESP-32_Based_Avionics_Telemetry_Board-B_Paste.gbp, ESP-32_Based_Avionics_Telemetry_Board-B_Silkscreen.gbo, ESP-32_Based_Avionics_Telemetry_Board-Edge_Cuts.gm1, ESP-32_Based_Avionics_Telemetry_Board-F_Cu.gtl, ESP-32_Based_Avionics_Telemetry_Board-F_Mask.gts, ESP-32_Based_Avionics_Telemetry_Board-F_Pas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]
2025-08-18 Add fabrication archive and Gerber check
2025-08-19 Add BOM and placement files
    [BOM.csv, positions.csv]
2025-08-20 Add rotation review and THT assembly list
    [Hand_Assembly_THT.csv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]
2025-08-21 Add schematic exports
